nickrenda/hw2_nickrenda_multi-tap-keyboard/img/switch.jpg

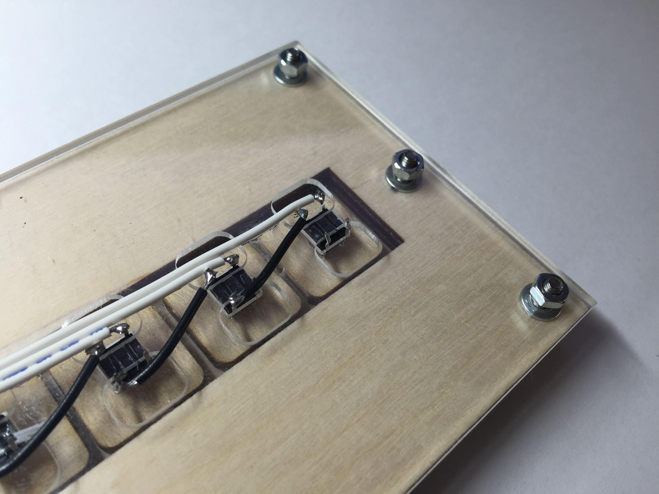
img/switch.jpg
