nickrenda/hw2_nickrenda_multi-tap-keyboard/(commit log)

2016-09-12 Added wiring diagram
2016-09-12 Updated wiring
